Blank428/hutch-drawers/projects/fit-test/fit_faceplate_black.3mf

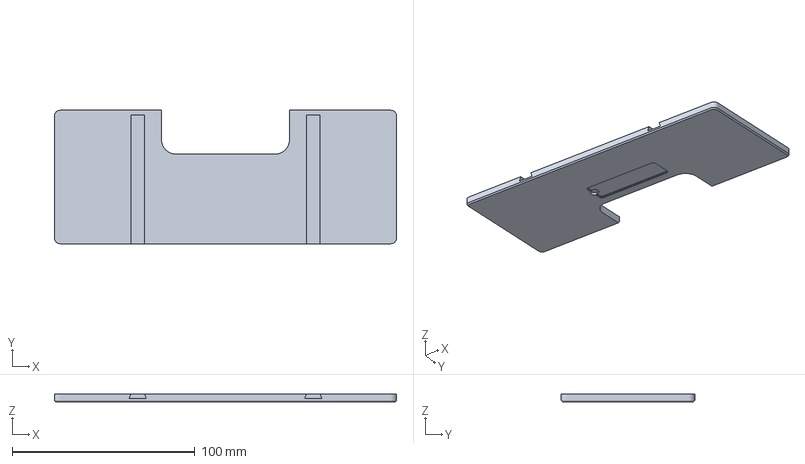
[picture p4: CAD file, 2026-11-05]
projects/fit-test/fit_faceplate_black.3mf
187.0 x 73.0 x 4.50 mm
