Blank428/hutch-drawers/projects/latches/latch_test_row_left.3mf

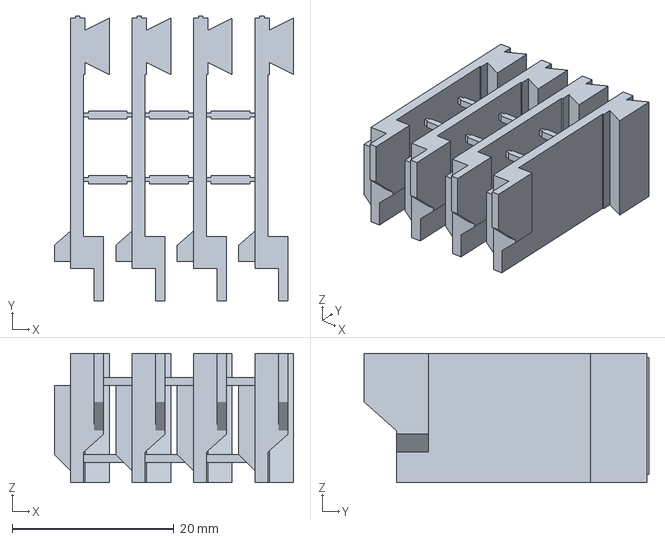
[picture p5: CAD file, 2026-11-05]
projects/latches/latch_test_row_left.3mf
29.6 x 35.2 x 16.0 mm
