Blank428/hutch-drawers/projects/modules-128mm/faceplate_128mm_black_x1.3mf

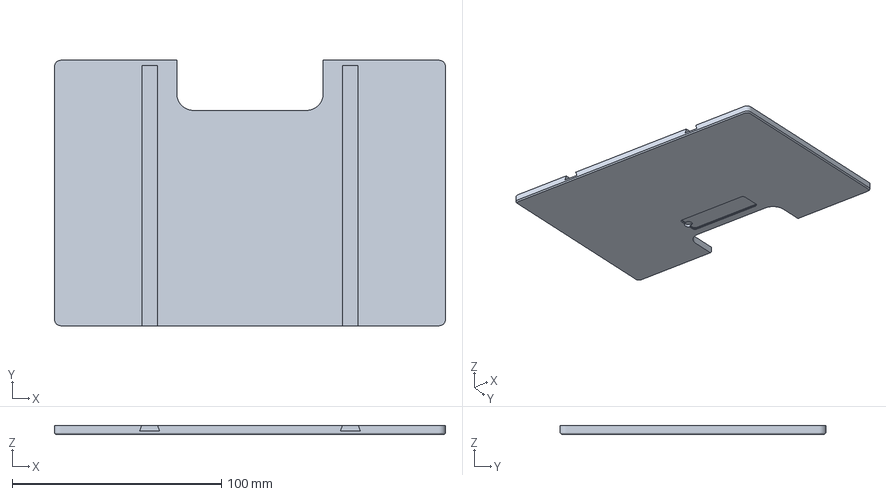
[picture p6: CAD file, 2026-11-05]
projects/modules-128mm/faceplate_128mm_black_x1.3mf
187.0 x 127.0 x 4.50 mm
