Blank428/hutch-drawers/projects/modules-71mm/frame_71mm.3mf

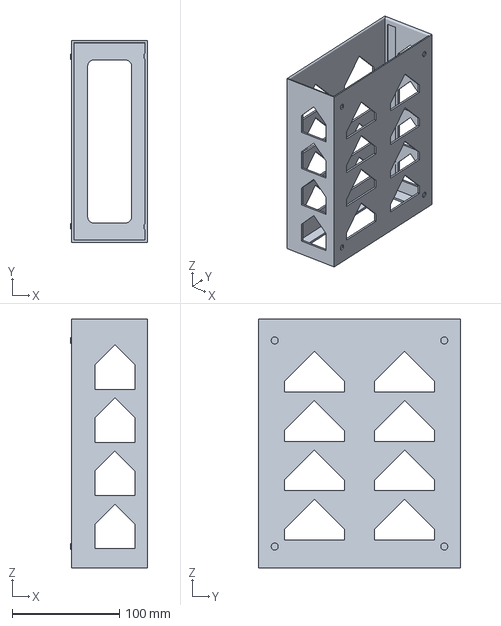
[picture p7: CAD file, 2026-11-05]
projects/modules-71mm/frame_71mm.3mf
72.2 x 188.0 x 232.0 mm
