Blank428/hutch-drawers/projects/modules-74mm/drawer_74mm.3mf

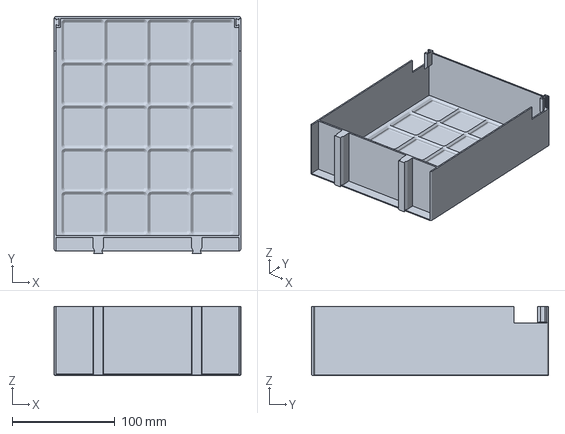
[picture p8: CAD file, 2026-11-05]
projects/modules-74mm/drawer_74mm.3mf
182.0 x 231.0 x 67.6 mm
