Blank428/hutch-drawers/projects/modules-89-5mm/drawer_89-5mm.3mf

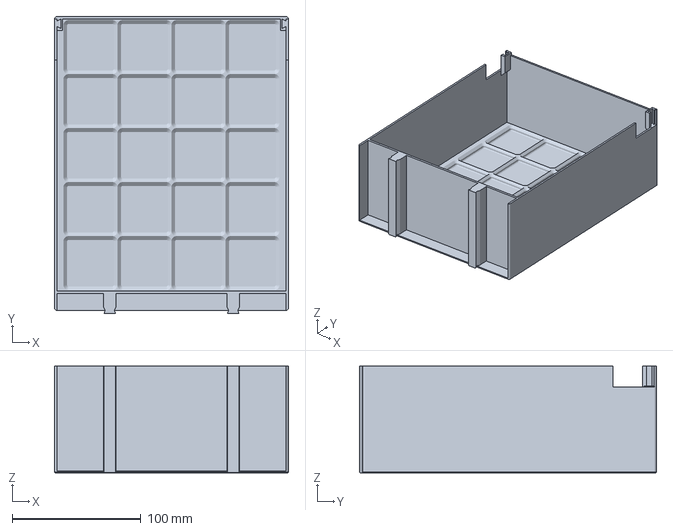
[picture p9: CAD file, 2026-11-05]
projects/modules-89-5mm/drawer_89-5mm.3mf
182.0 x 231.0 x 83.1 mm
