Blank428/hutch-drawers/projects/paper-shelf/paper_shelf_fit_test.3mf

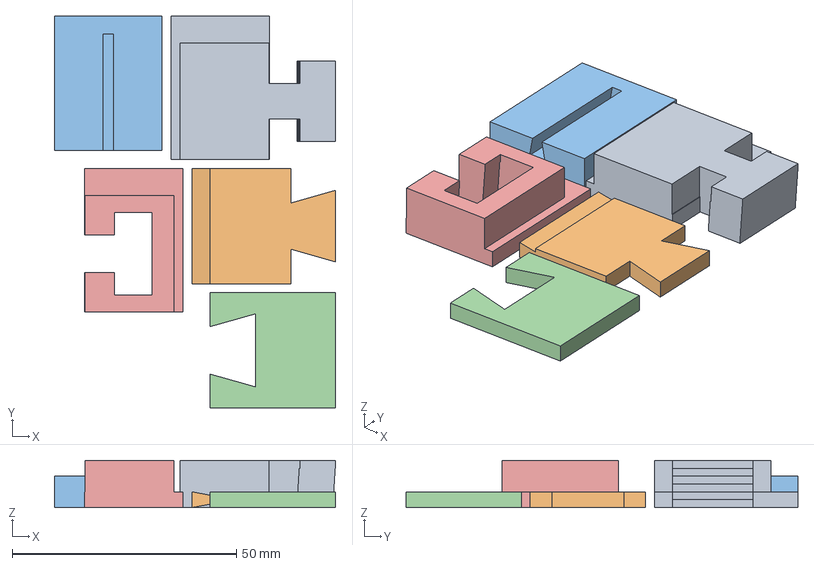
[picture p10: CAD file, 2026-11-05]
projects/paper-shelf/paper_shelf_fit_test.3mf
62.7 x 87.4 x 10.5 mm
paper_shelf_fit_test_seam_left.stl
paper_shelf_fit_test_shelf_a.stl
paper_shelf_fit_test_panel_slice.stl
paper_shelf_fit_test_shelf_b.stl
paper_shelf_fit_test_seam_right.stl
