Blank428/hutch-drawers/projects/tpu/top_spacers_3-5mm_x8.3mf

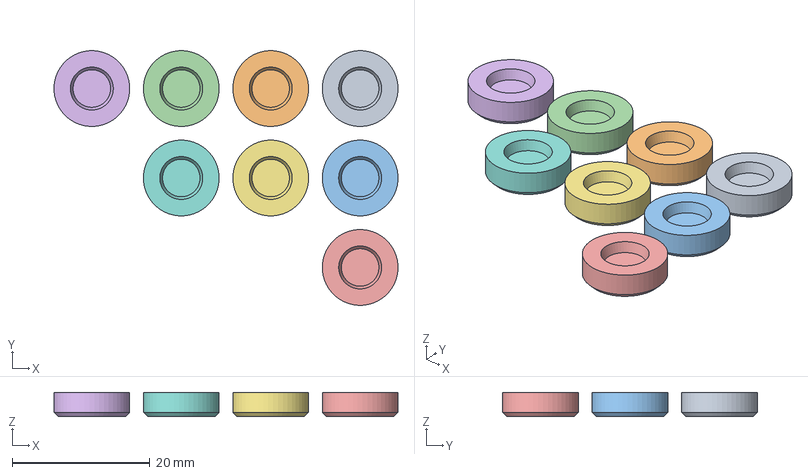
[picture p11: CAD file, 2026-11-05]
projects/tpu/top_spacers_3-5mm_x8.3mf
49.9 x 36.9 x 3.50 mm
top_spacer_3.5mm_x8_tpu.stl x 8
