Blank428/hutch-drawers/stl/faceplates/66mm_faceplate_x2_black.stl

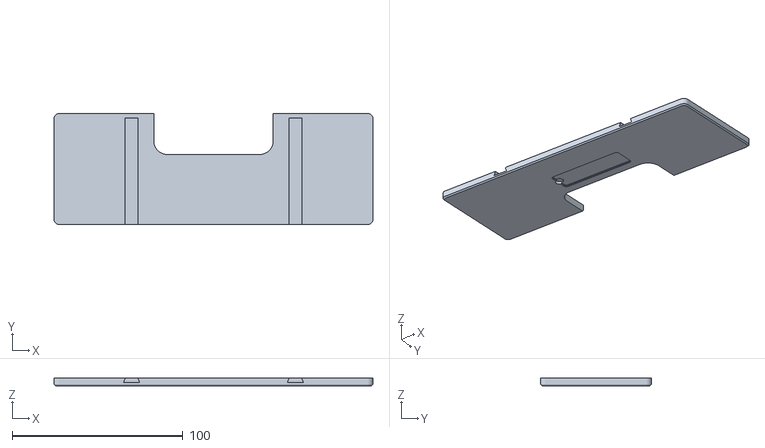
[picture p12: CAD file, 2026-11-05]
stl/faceplates/66mm_faceplate_x2_black.stl
187.0 x 65.0 x 4.50
