Blank428/hutch-drawers/stl/modules/128mm_frame_x2_black.stl

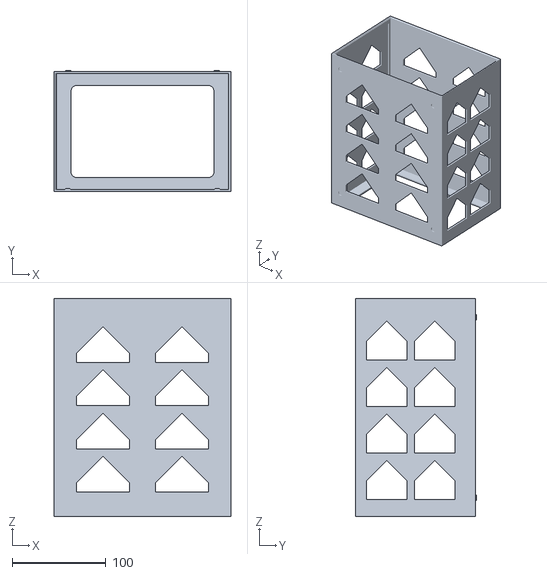
[picture p13: CAD file, 2026-11-05]
stl/modules/128mm_frame_x2_black.stl
188.0 x 129.2 x 232.0
