Blank428/hutch-drawers/stl/tpu/top_spacer_4-0mm_spare_size.stl

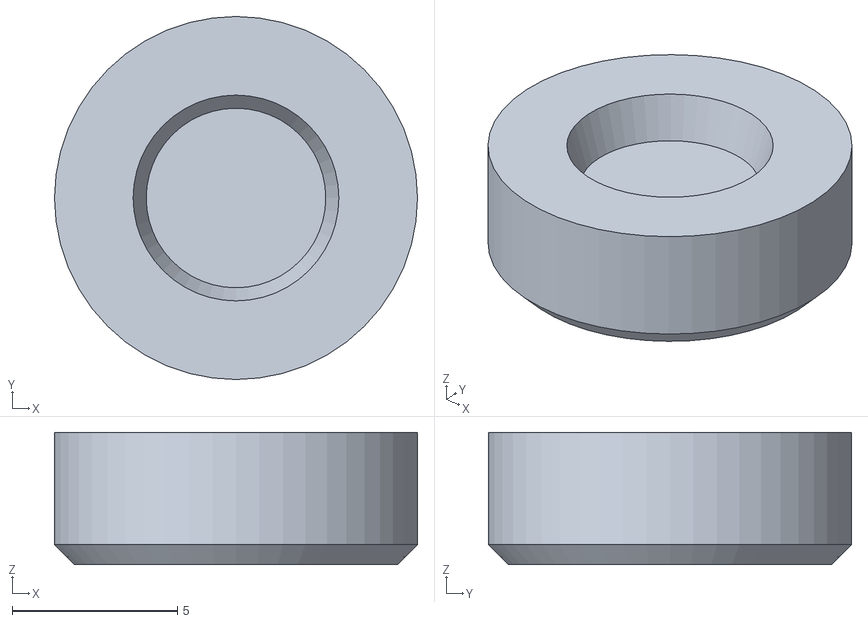
[picture p15: CAD file, 2026-11-05]
stl/tpu/top_spacer_4-0mm_spare_size.stl
11.0 x 11.0 x 4.00
