Blank428/hutch-drawers/projects/modules-128mm/drawer_128mm.3mf

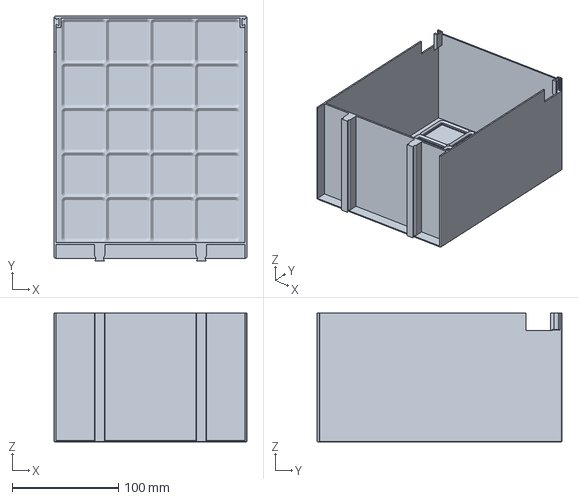
[picture p16: CAD file, 2026-11-05]
projects/modules-128mm/drawer_128mm.3mf
182.0 x 231.0 x 121.6 mm
