Blank428/hutch-drawers/projects/modules-71mm/faceplate_71mm_sage_x3.3mf

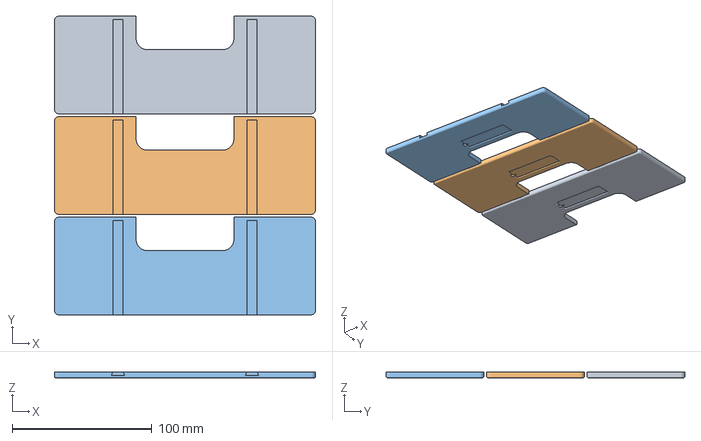
[picture p17: CAD file, 2026-11-05]
projects/modules-71mm/faceplate_71mm_sage_x3.3mf
187.0 x 214.0 x 4.50 mm
71mm_faceplate_x4_sage.stl x 3
