Blank428/hutch-drawers/projects/modules-89-5mm/faceplate_89-5mm_sage_x2.3mf

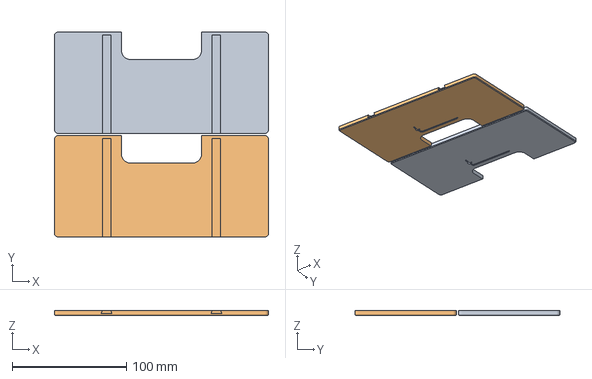
[picture p18: CAD file, 2026-11-05]
projects/modules-89-5mm/faceplate_89-5mm_sage_x2.3mf
187.0 x 179.0 x 4.50 mm
89.5mm_faceplate_x2_sage.stl x 2
