Blank428/hutch-drawers/projects/paper-shelf/paper_shelf_side_panels_x2.3mf

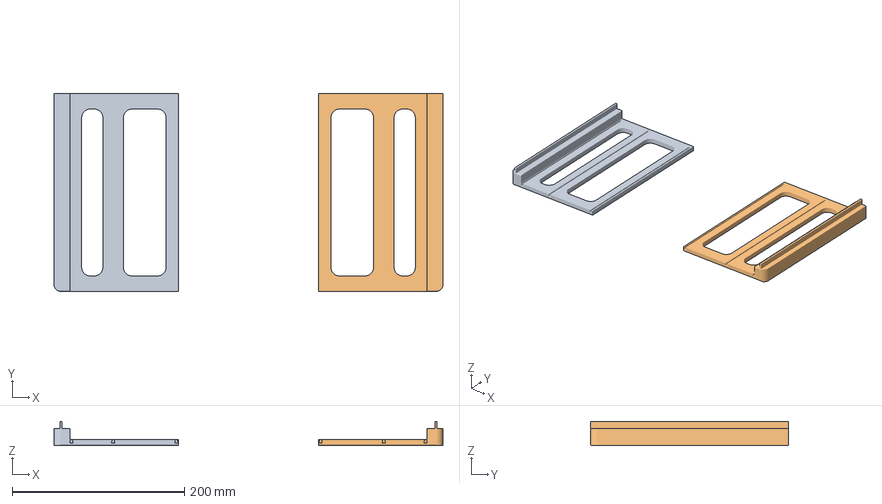
[picture p19: CAD file, 2026-11-05]
projects/paper-shelf/paper_shelf_side_panels_x2.3mf
452.2 x 230.0 x 28.0 mm
paper_shelf_side_panel_left.stl
paper_shelf_side_panel_right.stl
