Blank428/hutch-drawers/projects/tpu/top_spacers_3-0mm_x24.3mf

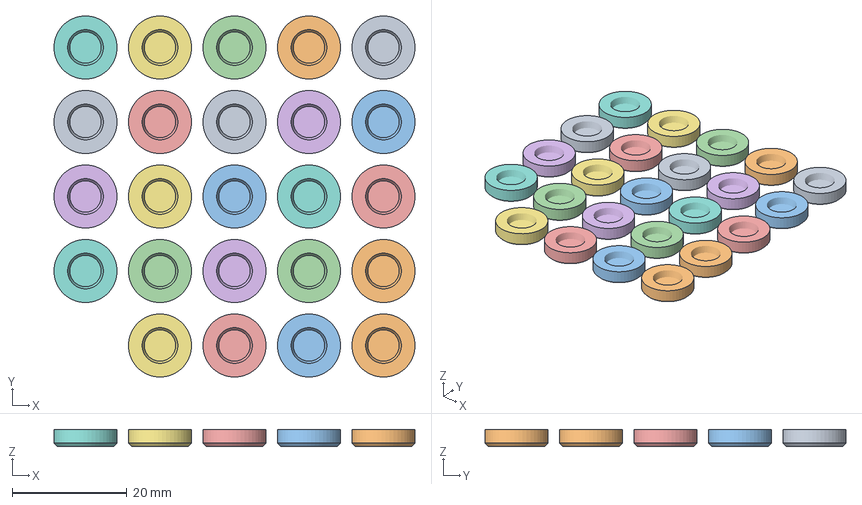
[picture p20: CAD file, 2026-11-05]
projects/tpu/top_spacers_3-0mm_x24.3mf
62.9 x 62.9 x 3.00 mm
top_spacer_3.0mm_x24_tpu.stl x 24
