Blank428/hutch-drawers/stl/faceplates/71mm_faceplate_x4_sage.stl

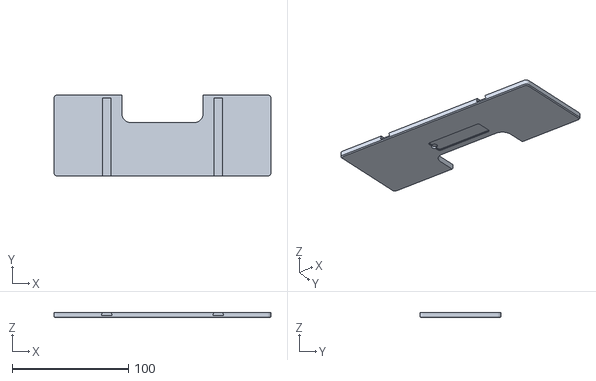
[picture p21: CAD file, 2026-11-05]
stl/faceplates/71mm_faceplate_x4_sage.stl
187.0 x 70.0 x 4.50
