Blank428/hutch-drawers/stl/fit-test/fit_drawer_x1_black.stl

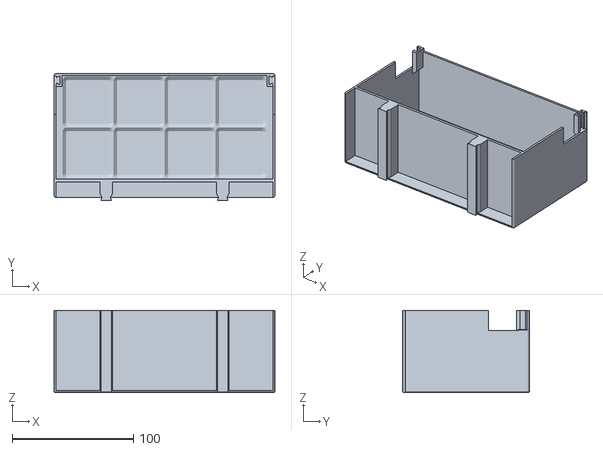
[picture p22: CAD file, 2026-11-05]
stl/fit-test/fit_drawer_x1_black.stl
182.0 x 104.6 x 67.6
