Blank428/hutch-drawers/stl/paper-shelf/paper_shelf_middle_shelf_left_half.stl

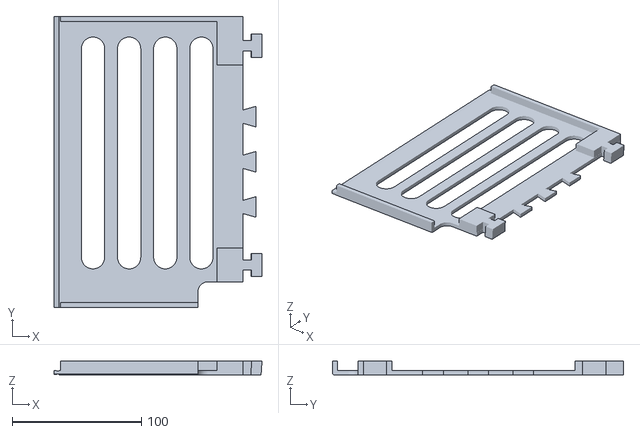
[picture p23: CAD file, 2026-11-05]
stl/paper-shelf/paper_shelf_middle_shelf_left_half.stl
161.2 x 225.7 x 10.5
