Blank428/hutch-drawers/stl/tpu/top_spacer_3-5mm_x8_tpu.stl

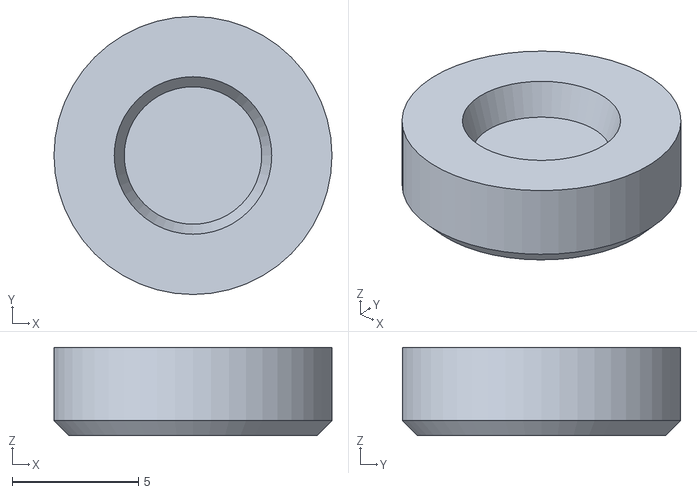
[picture p24: CAD file, 2026-11-05]
stl/tpu/top_spacer_3-5mm_x8_tpu.stl
11.0 x 11.0 x 3.50
