Blank428/hutch-drawers/projects/latches/latch_row_left.3mf

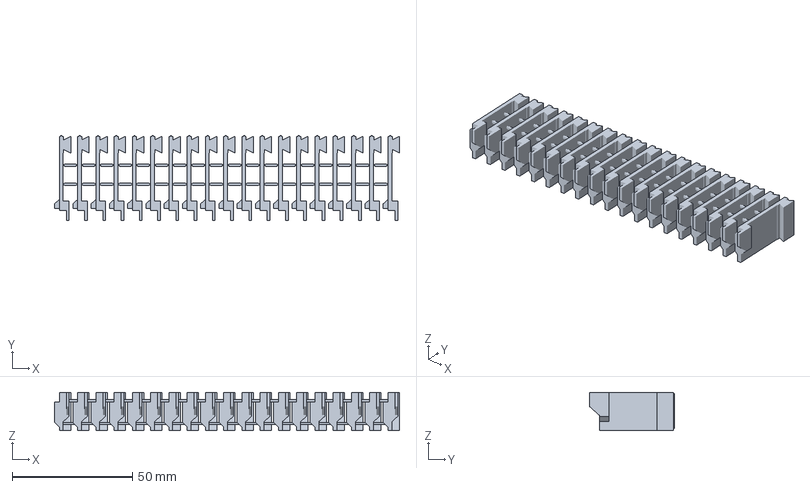
[picture p25: CAD file, 2026-11-05]
projects/latches/latch_row_left.3mf
143.6 x 35.2 x 16.0 mm
