Blank428/hutch-drawers/projects/modules-71mm/drawer_71mm.3mf

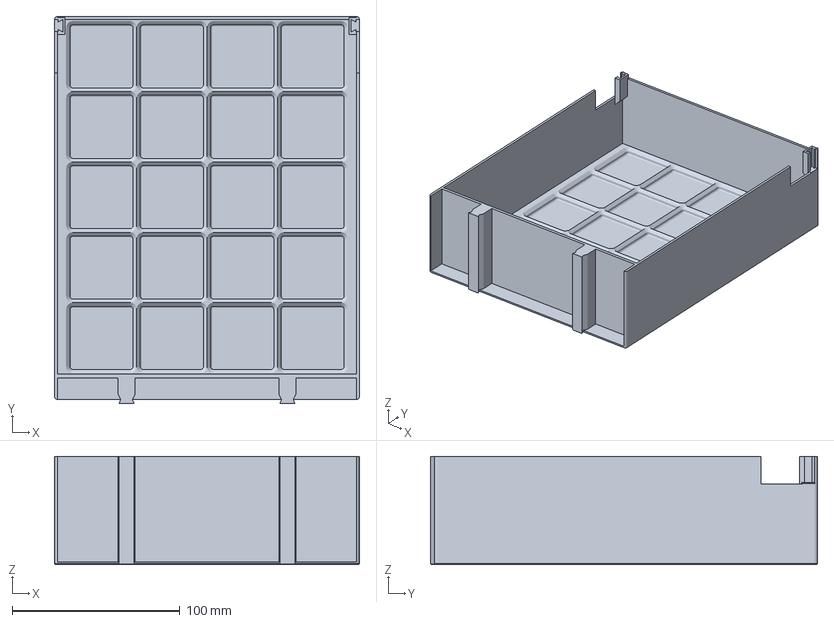
[picture p26: CAD file, 2026-11-05]
projects/modules-71mm/drawer_71mm.3mf
182.0 x 231.0 x 64.6 mm
