Blank428/hutch-drawers/projects/modules-74mm/frame_74mm.3mf

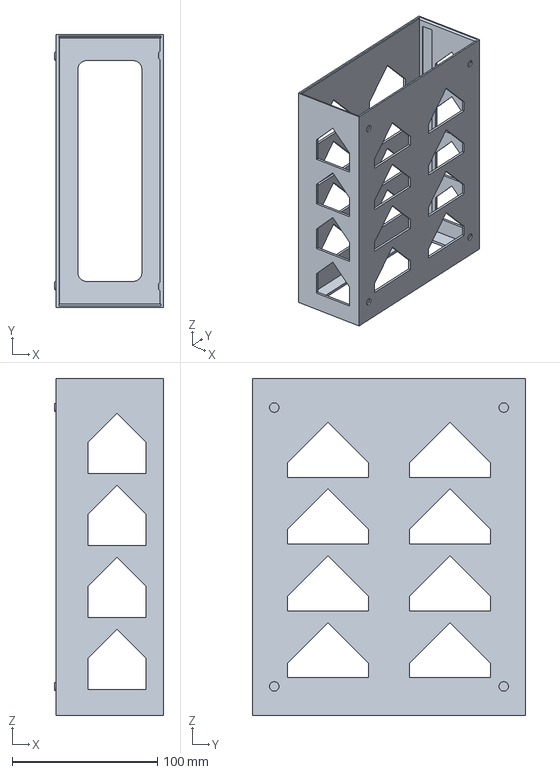
[picture p27: CAD file, 2026-11-05]
projects/modules-74mm/frame_74mm.3mf
75.2 x 188.0 x 232.0 mm
