Blank428/hutch-drawers/projects/modules-89-5mm/frame_89-5mm.3mf

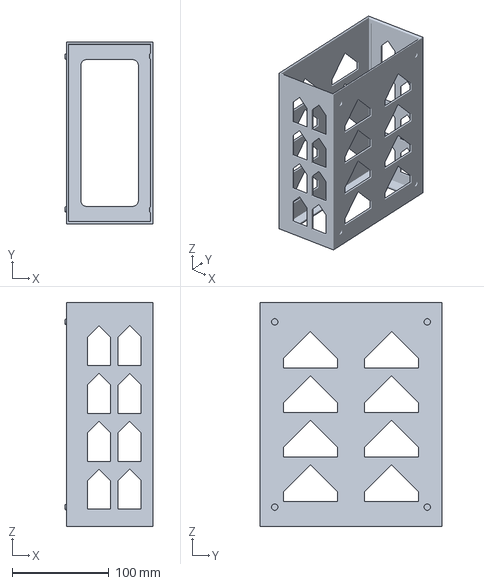
[picture p28: CAD file, 2026-11-05]
projects/modules-89-5mm/frame_89-5mm.3mf
90.7 x 188.0 x 232.0 mm
