Blank428/hutch-drawers/projects/paper-shelf/paper_shelf_shelf_halves_x6.3mf

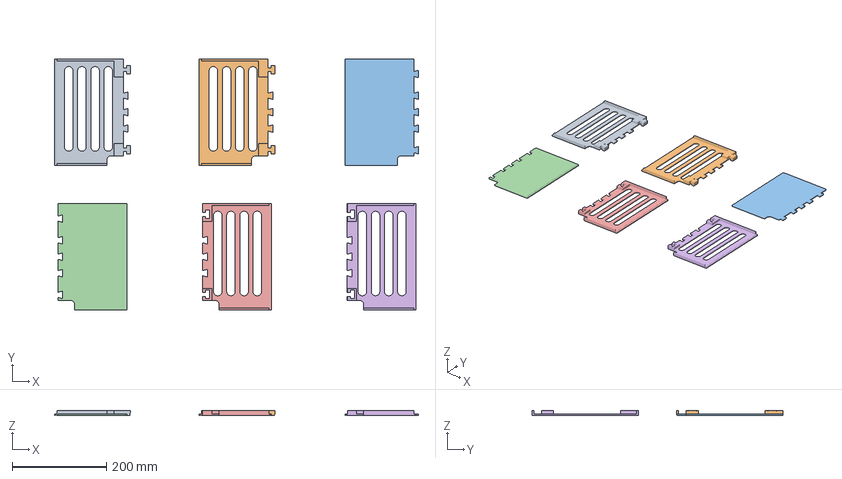
[picture p29: CAD file, 2026-11-05]
projects/paper-shelf/paper_shelf_shelf_halves_x6.3mf
773.3 x 532.9 x 10.5 mm
paper_shelf_middle_shelf_left_half.stl
paper_shelf_top_shelf_left_half.stl
paper_shelf_base_shelf_left_half.stl
paper_shelf_base_shelf_right_half.stl
paper_shelf_middle_shelf_right_half.stl
paper_shelf_top_shelf_right_half.stl
