Blank428/hutch-drawers/projects/tpu/foot_pads_x32.3mf

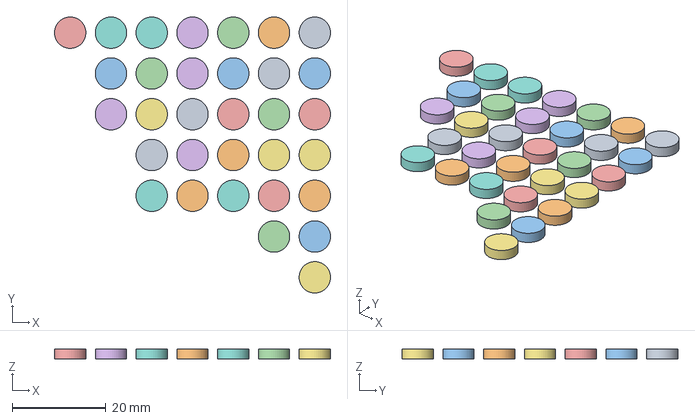
[picture p30: CAD file, 2026-11-05]
projects/tpu/foot_pads_x32.3mf
58.8 x 58.8 x 2.10 mm
foot_pad_x32_tpu.stl x 32
