Blank428/hutch-drawers/stl/fit-test/fit_frame_x1_black.stl

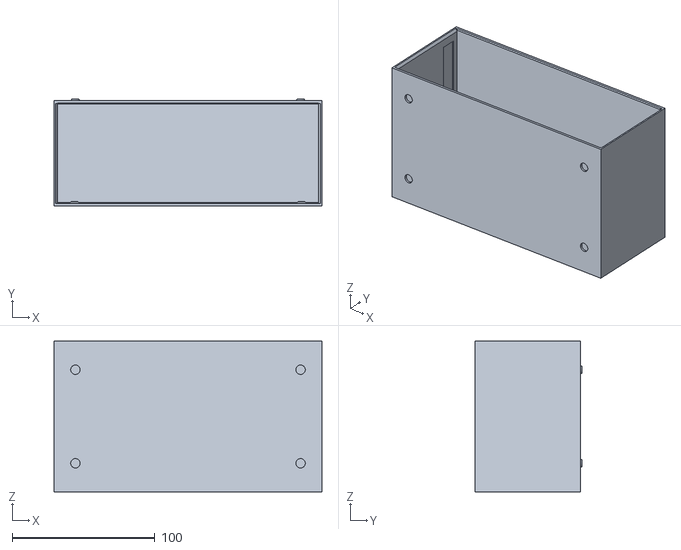
[picture p31: CAD file, 2026-11-05]
stl/fit-test/fit_frame_x1_black.stl
188.0 x 75.2 x 105.6
