Blank428/hutch-drawers/stl/paper-shelf/paper_shelf_fit_test_seam_left.stl

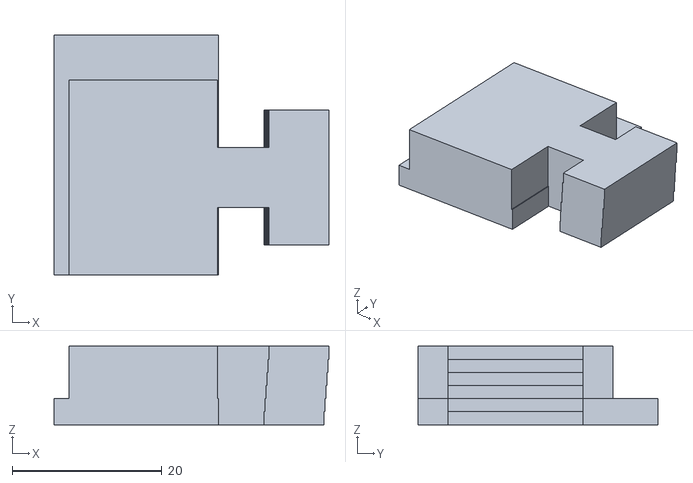
[picture p32: CAD file, 2026-11-05]
stl/paper-shelf/paper_shelf_fit_test_seam_left.stl
36.7 x 32.0 x 10.5
