Blank428/hutch-drawers/stl/tpu/foot_pad_x32_tpu.stl

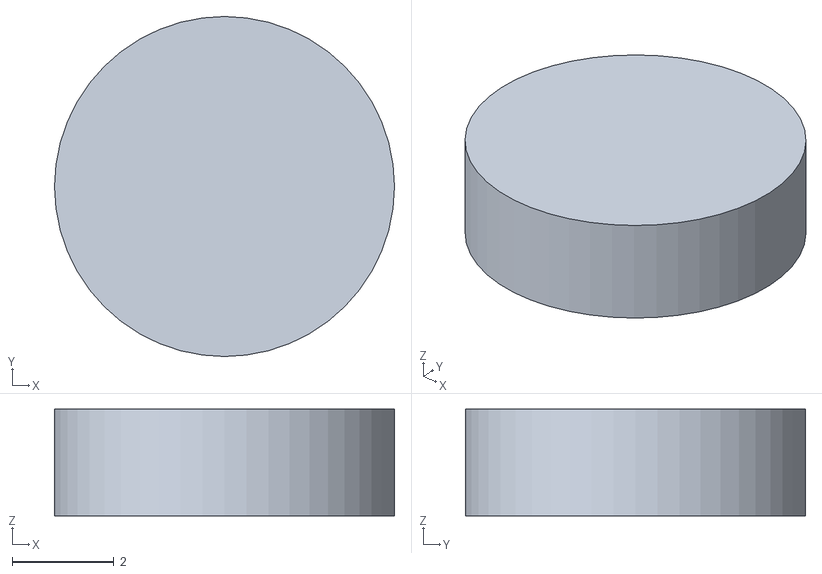
[picture p33: CAD file, 2026-11-05]
stl/tpu/foot_pad_x32_tpu.stl
6.70 x 6.70 x 2.10
