Blank428/hutch-drawers/projects/latches/latch_soft_test_row_right.3mf

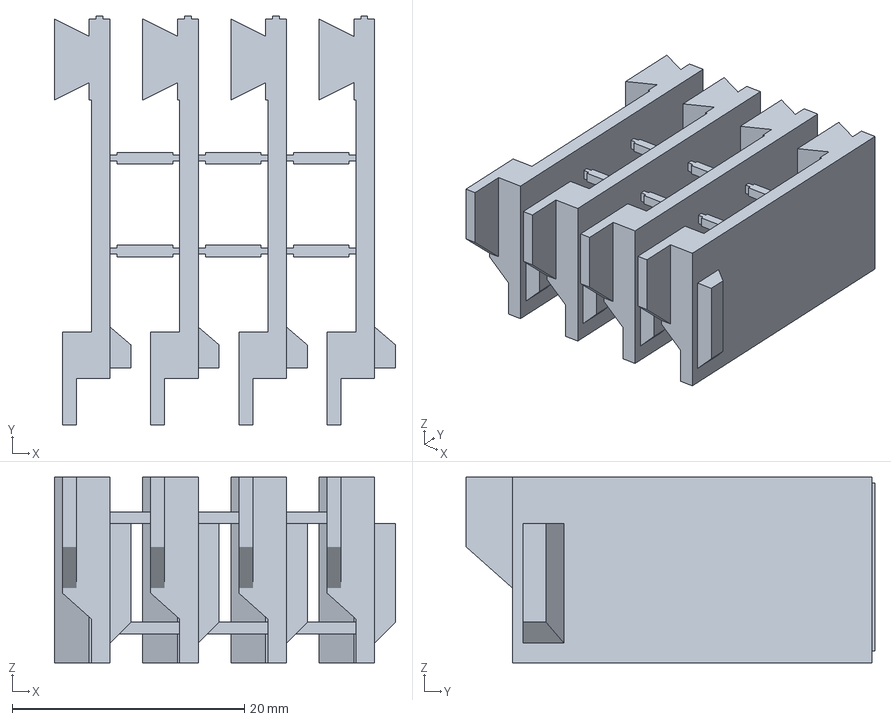
[picture p34: CAD file, 2026-11-05]
projects/latches/latch_soft_test_row_right.3mf
29.4 x 35.2 x 16.0 mm
