Blank428/hutch-drawers/projects/modules-66mm/drawer_66mm.3mf

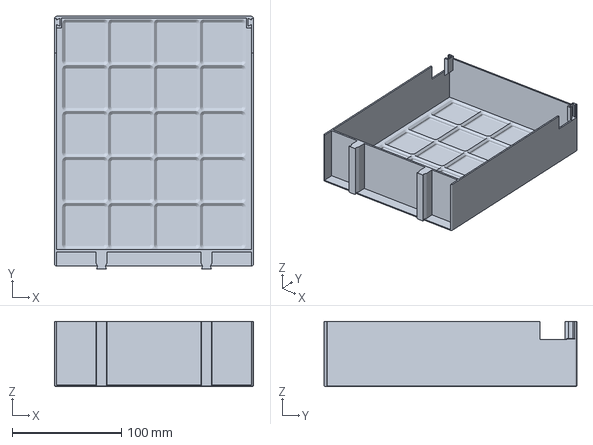
[picture p35: CAD file, 2026-11-05]
projects/modules-66mm/drawer_66mm.3mf
182.0 x 231.0 x 59.6 mm
