Blank428/hutch-drawers/projects/modules-74mm/faceplate_74mm_black_x3.3mf

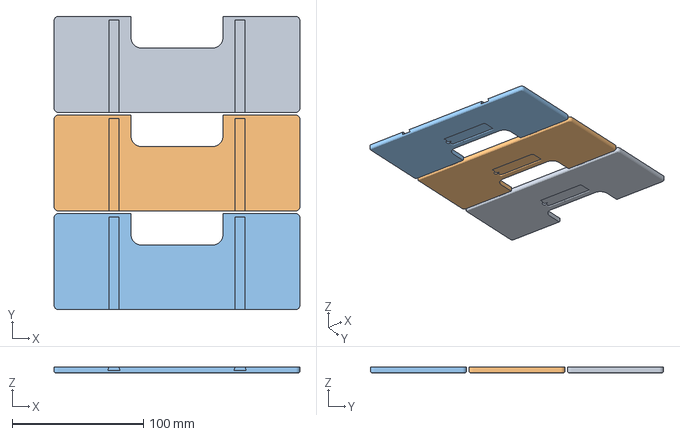
[picture p36: CAD file, 2026-11-05]
projects/modules-74mm/faceplate_74mm_black_x3.3mf
187.0 x 223.0 x 4.50 mm
74mm_faceplate_x6_black.stl x 3
