Blank428/hutch-drawers/projects/modules-89-5mm/faceplate_89-5mm_sage_x1.3mf

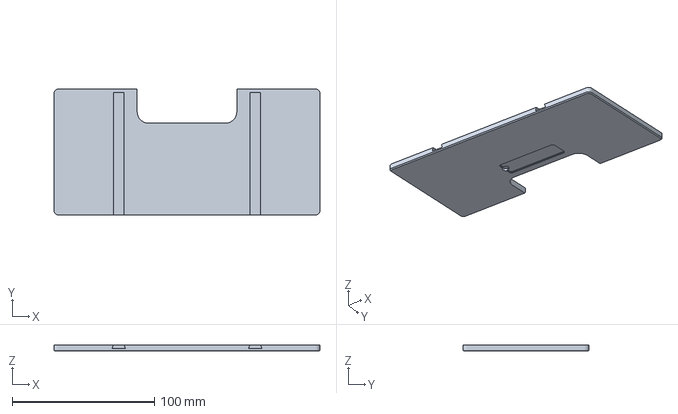
[picture p37: CAD file, 2026-11-05]
projects/modules-89-5mm/faceplate_89-5mm_sage_x1.3mf
187.0 x 88.5 x 4.50 mm
