Blank428/hutch-drawers/stl/fit-test/blank_tag_x1_any_colour.stl

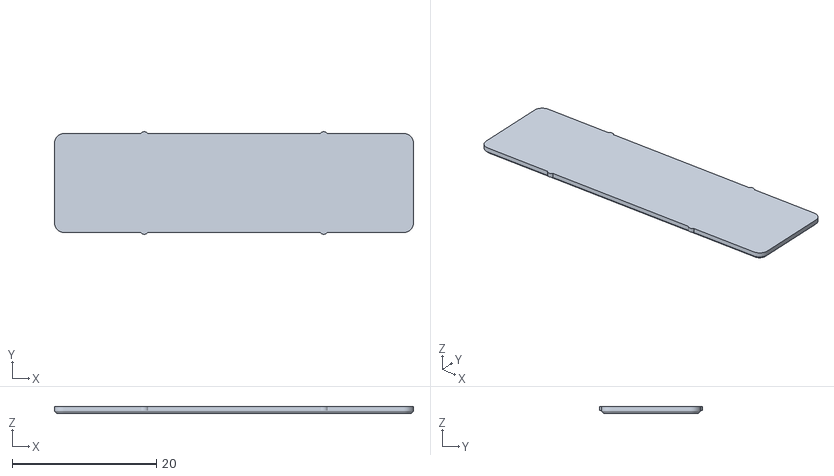
[picture p38: CAD file, 2026-11-05]
stl/fit-test/blank_tag_x1_any_colour.stl
49.7 x 14.2 x 1.00
