Blank428/hutch-drawers/stl/paper-shelf/paper_shelf_fit_test_seam_right.stl

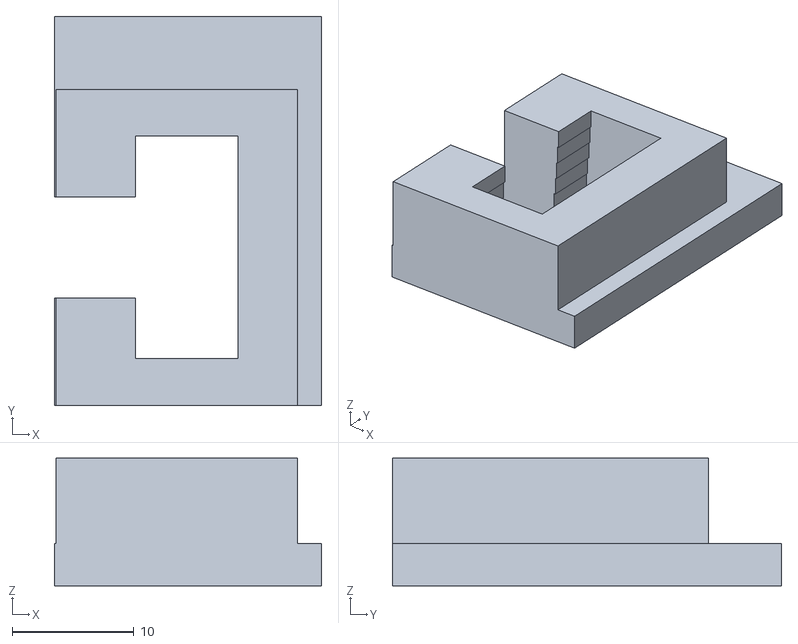
[picture p39: CAD file, 2026-11-05]
stl/paper-shelf/paper_shelf_fit_test_seam_right.stl
22.0 x 32.0 x 10.5
