Blank428/hutch-drawers/stl/tpu/top_spacer_3-0mm_x24_tpu.stl

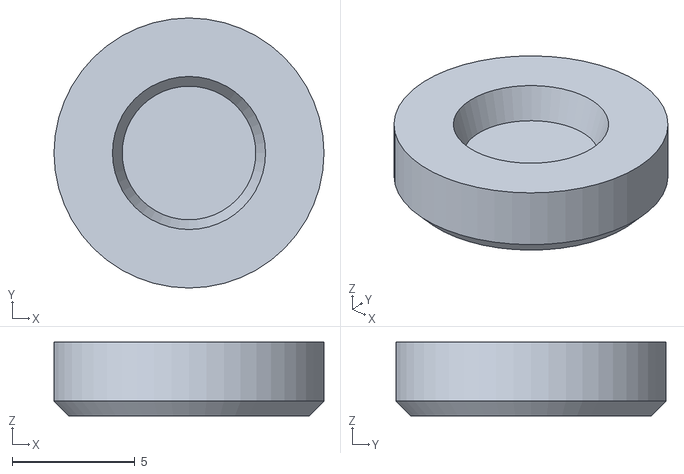
[picture p40: CAD file, 2026-11-05]
stl/tpu/top_spacer_3-0mm_x24_tpu.stl
11.0 x 11.0 x 3.00
