Blank428/hutch-drawers/stl/tpu/top_spacer_2-5mm_spare_size.stl

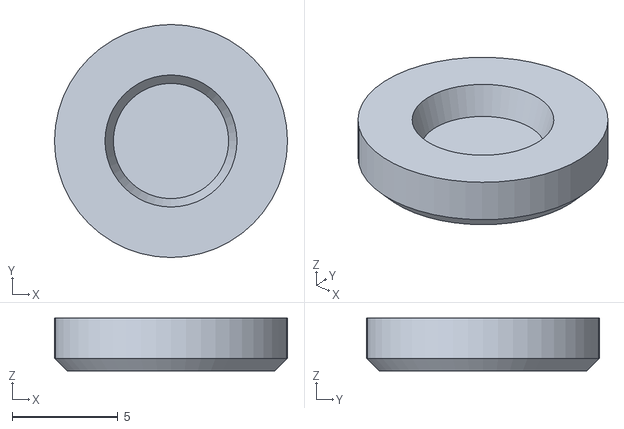
[picture p41: CAD file, 2026-11-05]
stl/tpu/top_spacer_2-5mm_spare_size.stl
11.0 x 11.0 x 2.50
