Blank428/hutch-drawers/projects/modules-66mm/frame_66mm.3mf

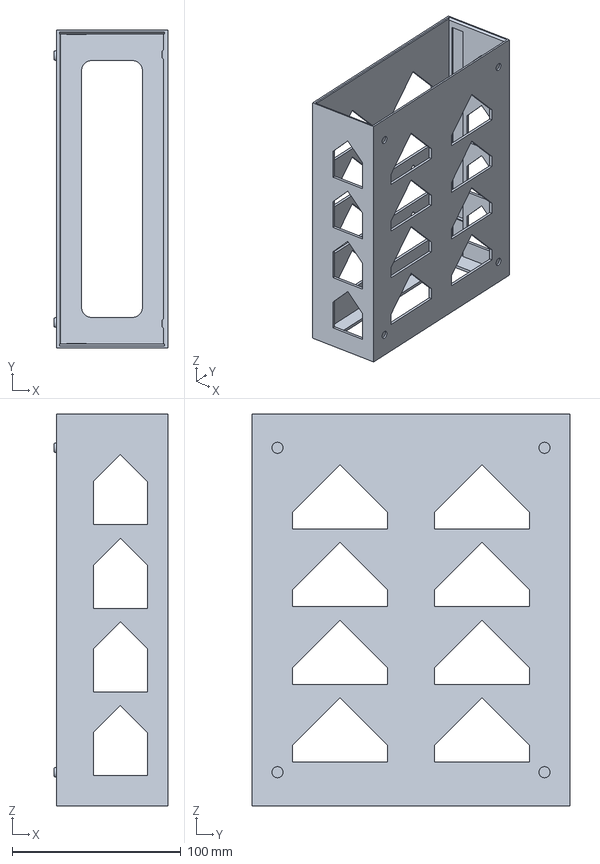
[picture p42: CAD file, 2026-11-05]
projects/modules-66mm/frame_66mm.3mf
67.2 x 188.0 x 232.0 mm
