Blank428/hutch-drawers/stl/paper-shelf/paper_shelf_side_panel_left.stl

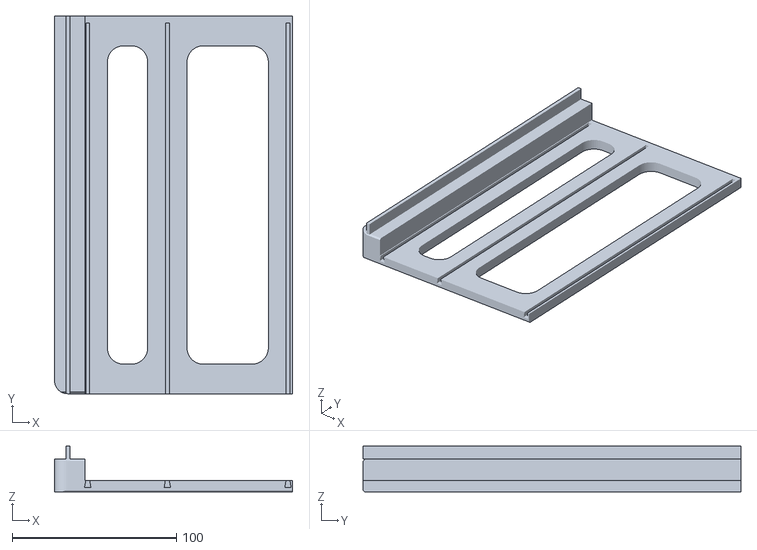
[picture p44: CAD file, 2026-11-05]
stl/paper-shelf/paper_shelf_side_panel_left.stl
145.0 x 230.0 x 28.0
