Blank428/hutch-drawers/stl/paper-shelf/paper_shelf_base_shelf_right_half.stl

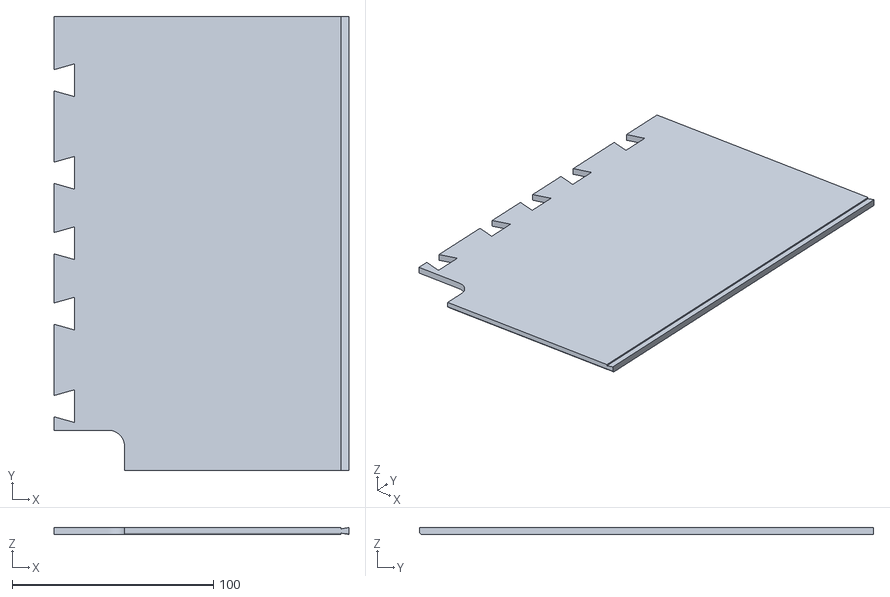
[picture p45: CAD file, 2026-11-05]
stl/paper-shelf/paper_shelf_base_shelf_right_half.stl
146.5 x 225.7 x 3.50
