Blank428/hutch-drawers/stl/paper-shelf/paper_shelf_base_shelf_left_half.stl

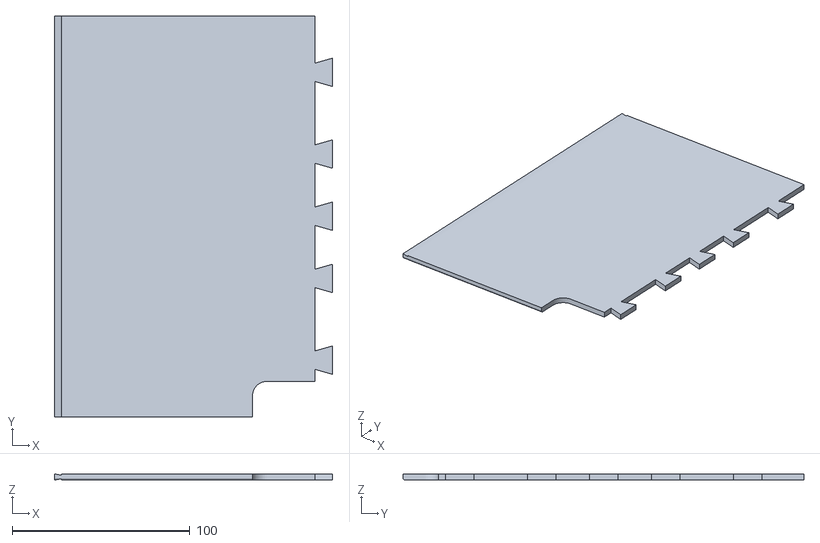
[picture p46: CAD file, 2026-11-05]
stl/paper-shelf/paper_shelf_base_shelf_left_half.stl
156.5 x 225.7 x 3.50
