Blank428/hutch-drawers/stl/paper-shelf/paper_shelf_fit_test_shelf_b.stl

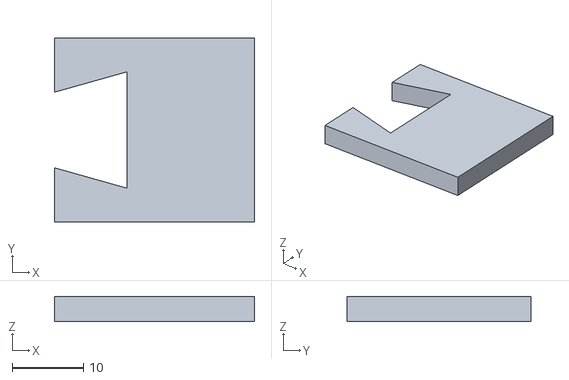
[picture p47: CAD file, 2026-11-05]
stl/paper-shelf/paper_shelf_fit_test_shelf_b.stl
28.0 x 25.7 x 3.50
