Blank428/hutch-drawers/stl/paper-shelf/paper_shelf_fit_test_panel_slice.stl

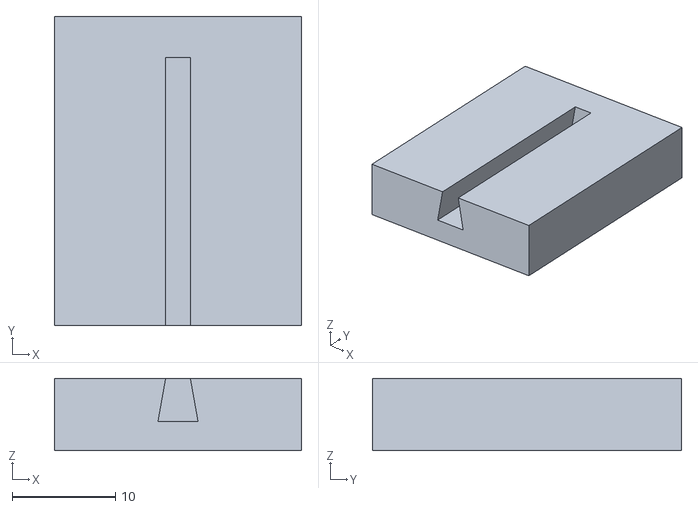
[picture p49: CAD file, 2026-11-05]
stl/paper-shelf/paper_shelf_fit_test_panel_slice.stl
24.0 x 30.0 x 7.00
