Blank428/hutch-drawers/(list of files, cad)

Other CAD files:
projects/modules-66mm/faceplate_66mm_sage_x2.3mf
stl/fit-test/fit_test_faceplate_x1.stl
stl/latches/latch_v3_test_row_x4_left.stl
projects/fit-test/fit_faceplate_sage.3mf
projects/latches/latch_firm_test_row_left.3mf
projects/modules-66mm/faceplate_66mm_black_x1.3mf
projects/modules-74mm/faceplate_74mm_black_x1.3mf
stl/latches/latch_v3_test_row_x4_right.stl
stl/modules/89-5mm_drawer_x2_black.stl
projects/fit-test/fit_drawer.3mf
projects/modules-128mm/frame_128mm.3mf
projects/modules-66mm/faceplate_66mm_sage_x1.3mf
stl/faceplates/128mm_faceplate_x2_black.stl
stl/latches/latch_v3_row_x19_left.stl
stl/modules/71mm_frame_x4_black.stl
projects/fit-test/fit_frame.3mf
projects/modules-71mm/faceplate_71mm_sage_x1.3mf
stl/latches/latch_v3_firm_test_row_x4_left.stl
stl/modules/74mm_frame_x6_black.stl
projects/latches/latch_test_row_right.3mf
projects/modules-66mm/faceplate_66mm_black_x2.3mf
stl/faceplates/89-5mm_faceplate_x2_sage.stl
stl/latches/latch_v3_firm_test_row_x4_right.stl
stl/modules/66mm_drawer_x4_black.stl
stl/paper-shelf/paper_shelf_middle_shelf_right_half.stl
projects/latches/latch_soft_test_row_left.3mf
stl/faceplates/74mm_faceplate_x6_black.stl
stl/latches/latch_v3_row_x19_right.stl
stl/modules/74mm_drawer_x6_black.stl
projects/latches/latch_firm_test_row_right.3mf
stl/latches/latch_v3_soft_test_row_x4_right.stl
stl/modules/71mm_drawer_x4_black.stl
projects/latches/latch_row_right.3mf
stl/latches/latch_v3_soft_test_row_x4_left.stl
stl/modules/89-5mm_frame_x2_black.stl
stl/paper-shelf/paper_shelf_side_panel_right.stl
stl/modules/128mm_drawer_x2_black.stl
stl/modules/66mm_frame_x4_black.stl
