Blank428/hutch-drawers/(commit log)

2026-11-05 Hutch drawer system: Bambu Studio projects, STLs and source
    36 ready-to-print Bambu Studio projects for the A1 (built and slice-checked
    with Bambu Studio 2.8.2), print-oriented STLs, the parametric source, and a
    manifest with Bambu's gram and time estimates.
    Claude-Session: https://claude.ai/code/session_01WP9WFZdcHPv2upWMo9GzsY
    [128mm_drawer_x2_black.stl, 128mm_faceplate_x2_black.stl, 128mm_frame_x2_black.stl, 66mm_drawer_x4_black.stl, 66mm_faceplate_x2_black.stl, 66mm_faceplate_x2_sage.stl, 66mm_frame_x4_black.stl, 71mm_drawer_x4_black.stl]
2026-11-05 Add Mac helper: open projects locally in Bambu Studio and build label plates
    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
2026-11-05 Add paper and build-plate shelf for the top-left cubby
    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
    [paper_shelf_base_shelf_left_half.stl, paper_shelf_base_shelf_right_half.stl, paper_shelf_fit_test.3mf, paper_shelf_fit_test_panel_slice.stl, paper_shelf_fit_test_shelf_a.stl, paper_shelf_fit_test_shelf_b.stl, paper_shelf_middle_shelf_left_half.stl, paper_shelf_middle_shelf_right_half.stl]
2026-11-05 Paper shelf: finger notches, rounded panel corners, chamfered front edges
    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
    [paper_shelf_base_shelf_left_half.stl, paper_shelf_base_shelf_right_half.stl, paper_shelf_fit_test.3mf, paper_shelf_middle_shelf_left_half.stl, paper_shelf_middle_shelf_right_half.stl, paper_shelf_shelf_halves_x6.3mf, paper_shelf_side_panel_left.stl, paper_shelf_side_panel_right.stl]
2026-11-05 Paper shelf: lighter design (windowed panels, slatted middle and top shelves, solid base)
    About 615 g instead of 796 g. Joints and fit test unchanged.
    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
    [paper_shelf_fit_test.3mf, paper_shelf_middle_shelf_left_half.stl, paper_shelf_middle_shelf_right_half.stl, paper_shelf_shelf_halves_x6.3mf, paper_shelf_side_panel_left.stl, paper_shelf_side_panel_right.stl, paper_shelf_side_panels_x2.3mf, paper_shelf_top_shelf_left_half.stl]
2026-11-05 Paper shelf: stiff centre seam (deep tapered T-tabs through plate and keel), seam sample in fit test
    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
    [paper_shelf_fit_test.3mf, paper_shelf_fit_test_seam_left.stl, paper_shelf_fit_test_seam_right.stl, paper_shelf_middle_shelf_left_half.stl, paper_shelf_middle_shelf_right_half.stl, paper_shelf_shelf_halves_x6.3mf, paper_shelf_side_panels_x2.3mf, paper_shelf_top_shelf_left_half.stl]
